AGVOLUTION/arduino_weatherstation/images/solar_6.JPEG

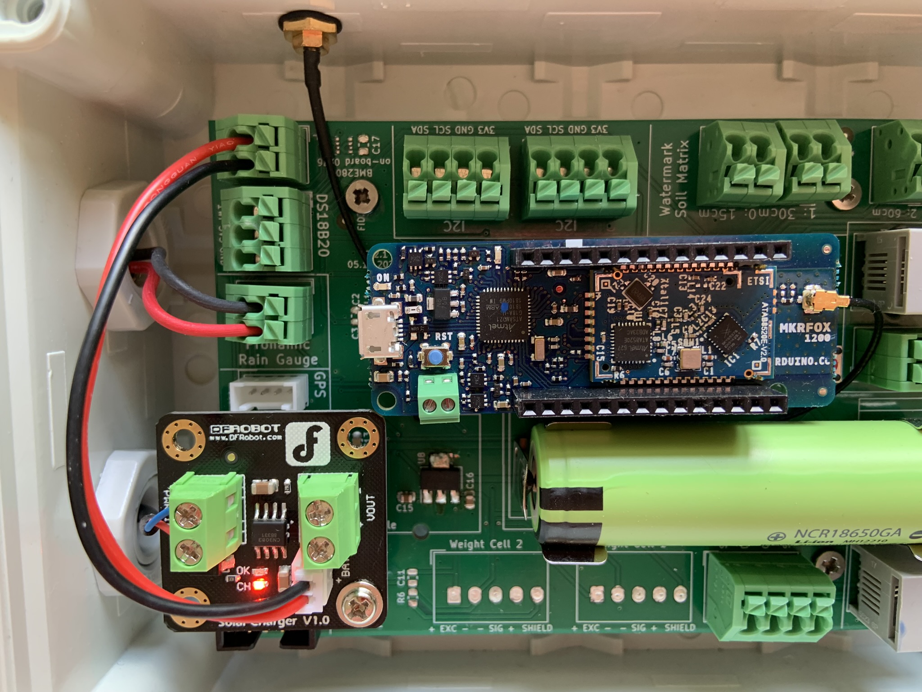
images/solar_6.JPEG
