AGVOLUTION/arduino_weatherstation/images/solar_3.JPEG

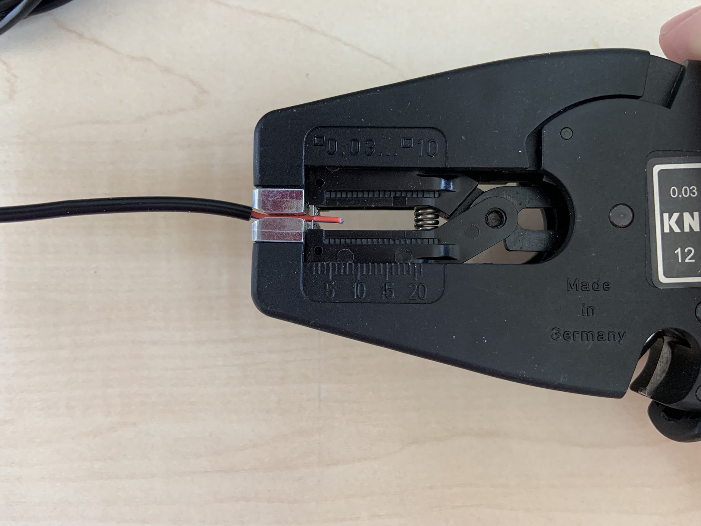
images/solar_3.JPEG
