AGVOLUTION/arduino_weatherstation/images/Farmalyzer_app_quer.png

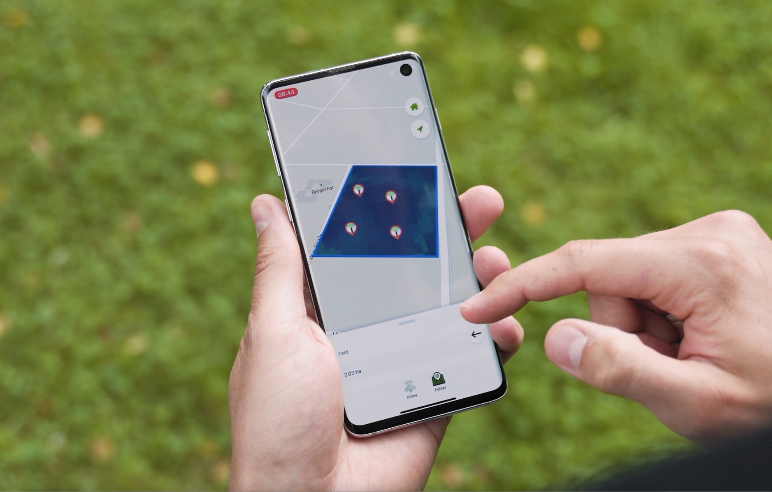
images/Farmalyzer_app_quer.png
