AGVOLUTION/arduino_weatherstation/images/sigfox_prototyp1.jpg

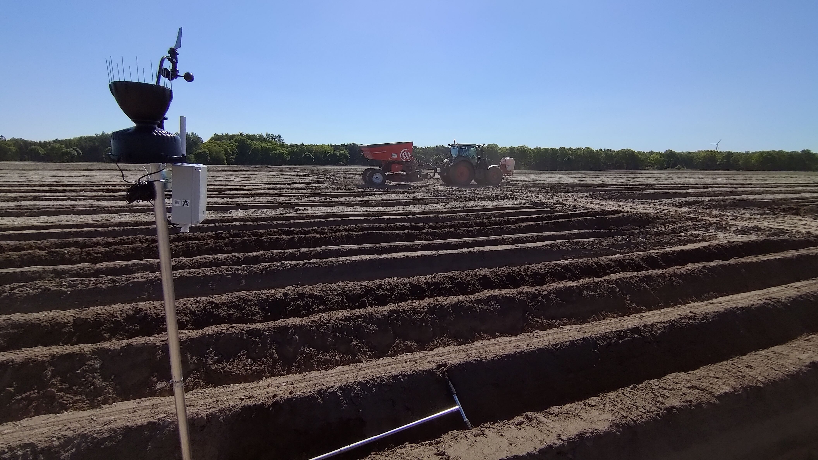
images/sigfox_prototyp1.jpg
