AGVOLUTION/arduino_weatherstation/images/sigfox_prototyp2.jpg

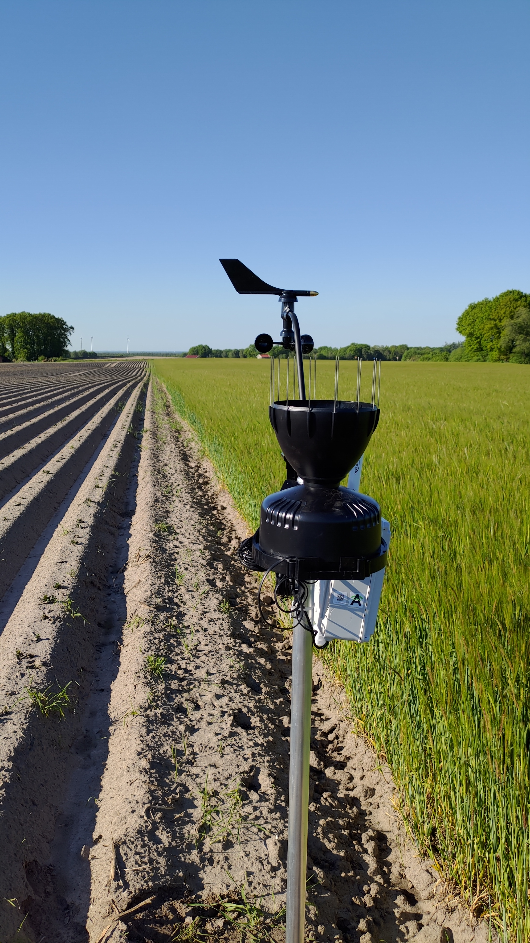
images/sigfox_prototyp2.jpg
