AGVOLUTION/arduino_weatherstation/images/solar_1.JPEG

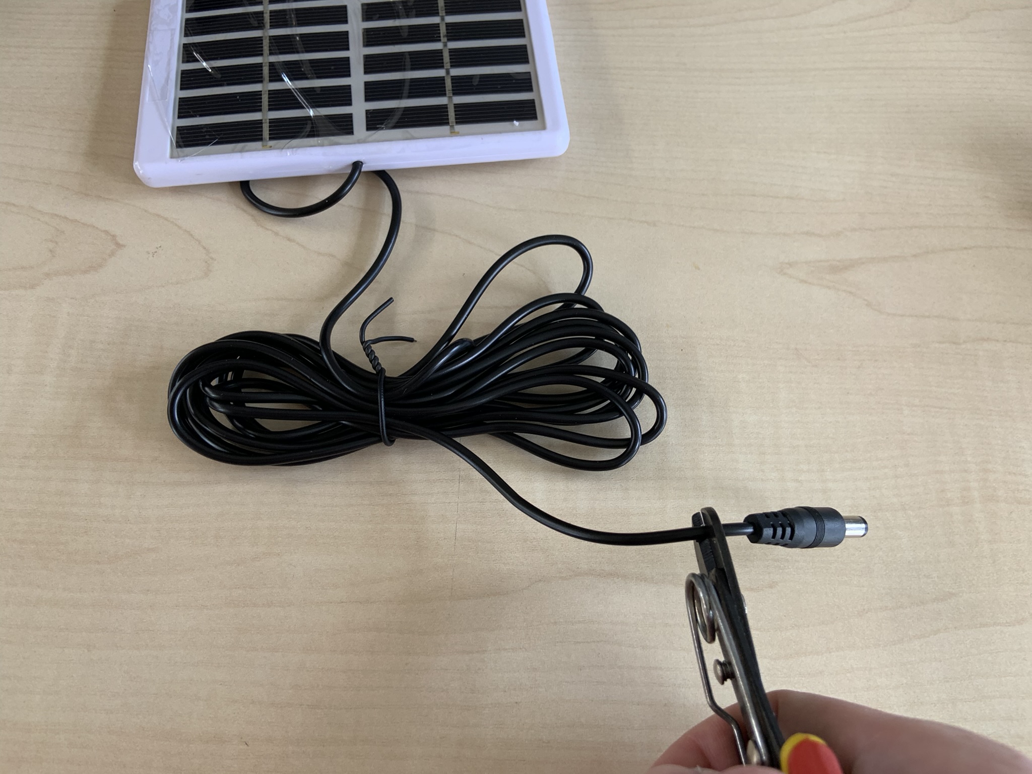
images/solar_1.JPEG
