AGVOLUTION/arduino_weatherstation/images/solar_2.JPEG

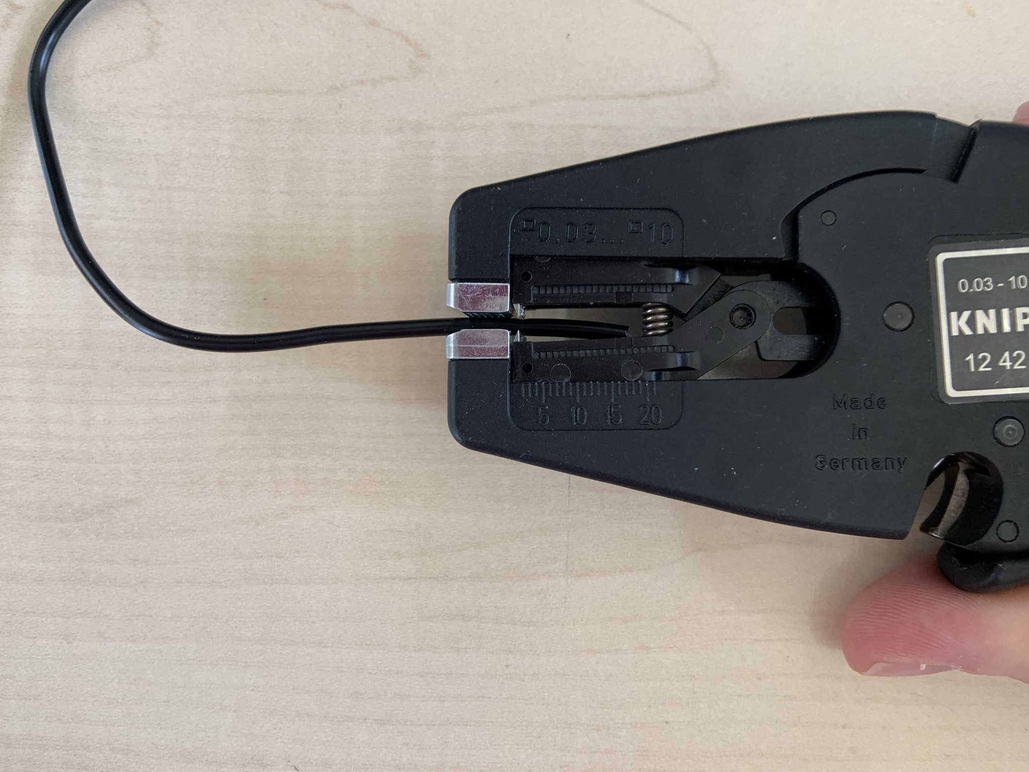
images/solar_2.JPEG
