AGVOLUTION/arduino_weatherstation/images/solar_4.JPEG

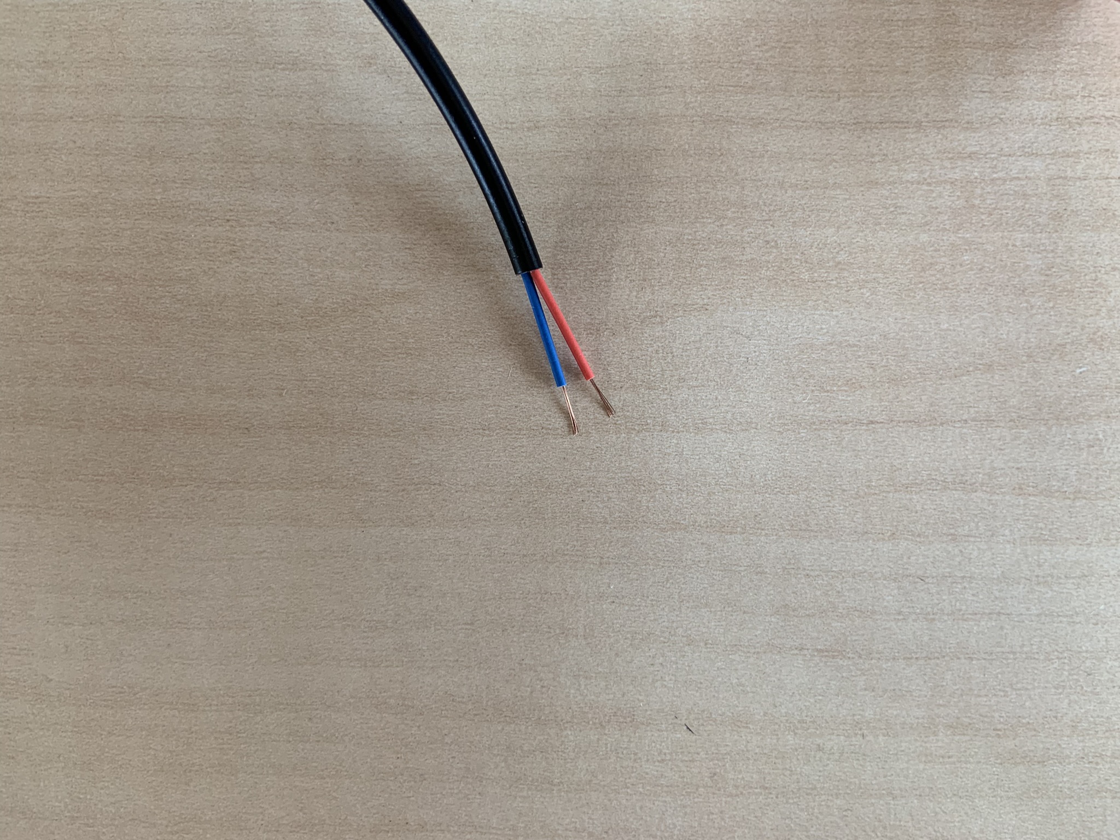
images/solar_4.JPEG
