AGVOLUTION/arduino_weatherstation/images/solar_5.JPEG

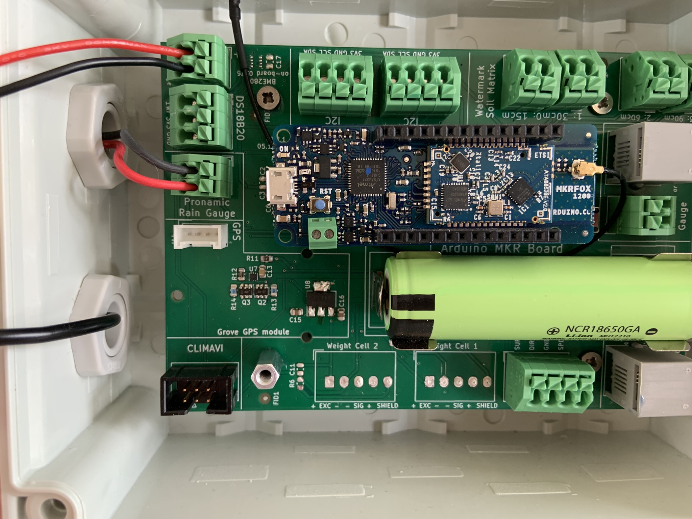
images/solar_5.JPEG
