AGVOLUTION/arduino_weatherstation/images/wind_1.JPEG

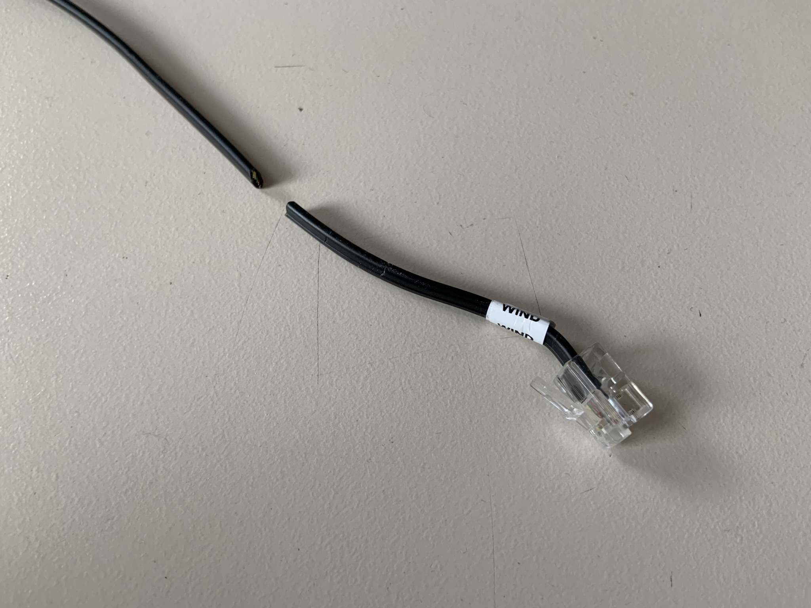
images/wind_1.JPEG
