AGVOLUTION/arduino_weatherstation/images/wind_2.JPEG

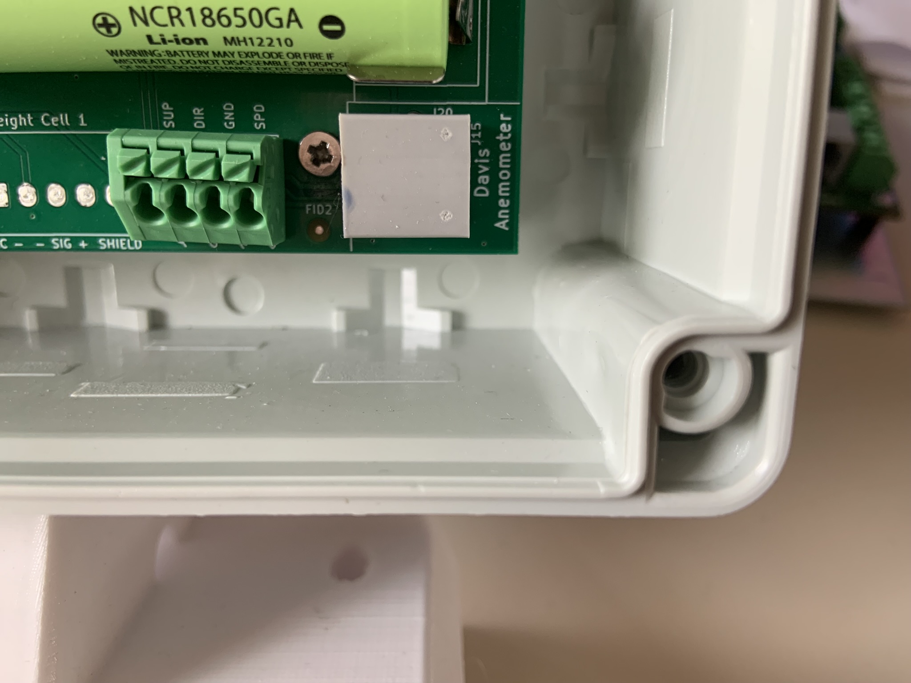
images/wind_2.JPEG
