AGVOLUTION/arduino_weatherstation/images/wind_3.JPEG

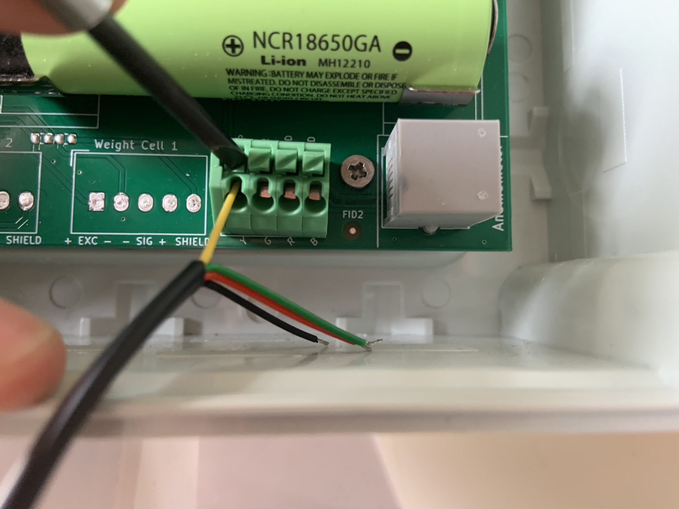
images/wind_3.JPEG
