AGVOLUTION/arduino_weatherstation/images/wind_4.JPEG

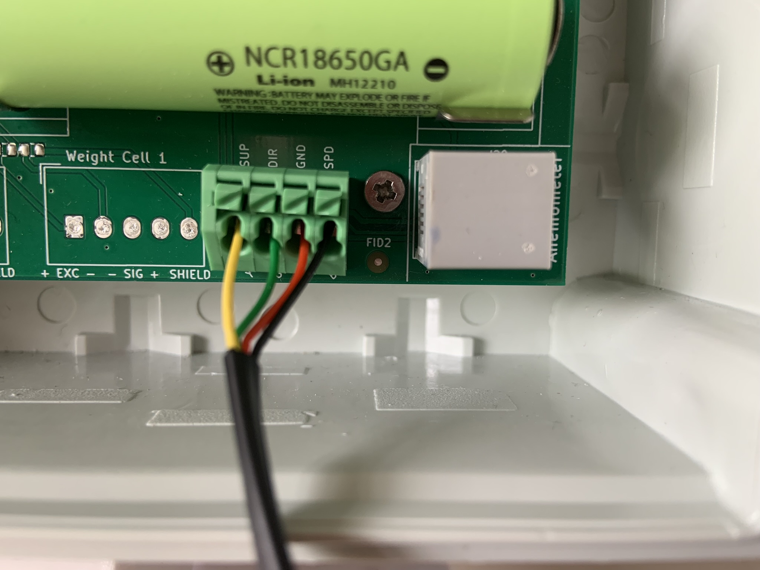
images/wind_4.JPEG
