AGVOLUTION/arduino_weatherstation/hardware/V2.2.1/BOM Wetterstation_25_10_21.ods

 | BOM Wetterstation V2_2_1
 | 25/10/2021
Qty | Value | Package | Part | Description | Voltage | Current | Tolerance | Manufacturer | Manuf. Part No. | Distributor | Distr. Part No. | Anmerkung
3 | 100nF | C_0805_2012Metric | C1, C13, C14 | Unpolarized capacitor | 5V
0 | 100nF | C_0805_2012Metric | C2, C3, C4, C5, C6, C7, C8, C9, C10, C11, C12, C17 | Unpolarized capacitor |  |  |  |  |  |  |  | Nicht bestückt.
2 | 4.7 uF | C_0805_2012Metric | C15, C16 | Unpolarized capacitor | 3,3V
7 | Conn_01x02_Male | 1x02_P3.50mm_Vertical | J1, J5, J6, J8, J9, J10, J21 | Generic connector, single row, 01x02 | X | X | X | Phoenix Contact | 1984963 | Digikey | 277-6354-ND | https://de.farnell.com/wago/250-102/tb-wire-to-brd-2pos-16awg/dp/3276925?st=250-102
1 | Conn_01x03_Male | 1x03_P3.50mm_Vertical | J11 | Generic connector, single row, 01x03 | X | X | X | Phoenix Contact | 1984976 | Digikey | 277-6355-ND
3 | Conn_01x04_Male | 1x04_P3.50mm_Vertical | J4, J12, J13 | Generic connector, single row, 01x04 | X | X | X | Phoenix Contact | 1984989 | Digikey | 277-6404-ND
0 | Conn_01x05_Female | 1x05_P3.50mm_Vertical | J17, J18 | Generic connector, single row, 01x05 | X | X | X | Phoenix Contact | 1861962 | Digikey | 277-12127-ND | Nicht bestückt.
1 | Conn_01x04_Male | 1x04_P2.00mm_Vertical | J14 | GROVE 2MM 4PIN VERT CONN | X | X | X | Seeed Technology Co., Ltd. | 110990030 | Digikey | 1597-1082-ND
2 | Conn_01x14_Female | 1x14_P2.54mm_Vertical | J2, J3 | Conn header vert 14pos 2.54mm | X | X | X | Sullins Connector Solutions | PPPC141LFBN-RC | Digikey | S7047-ND
1 | Conn_02x03_Odd_Even | IDC-Header_2x03_P2.54mm_Vertical | J7 | IDC Connector 6pos | X | X | X | 3M | 30306-6002HB | Digikey | 3M15451-ND | Vergoldete Kontakte wichtig!
0 | RJ14 | RJ14_Connfly_DS1133-S4_Horizontal | J15, J16 | RJ connector, 6P4C (6 positions 4 connected) | X | X | X | Würth | 615004138421 | Würth |  | Nicht bestückt.
2 | Conn_01x01_Female | BatteryHolder_Keystone_Clip_54 | J19, J20 | Generic connector, single row, 01x01 | X | X | X | Keystone Electronics | 54 | Digikey | 36-54-ND
0 | 4.7uH | L_0805_2012Metric | L1 | Inductor | X | 600 mA | 20,00% | TDK Corporation | MLZ2012N4R7LT000 | Digikey | 445-6760-1-ND | Nicht bestückt.
1 | DMN65D8LDW | SOT-363, SC-70-6 | Q1 | MOSFET 2N-CH 60V 180MA SOT363 | 60 V | 200 mA | X | Diodes Incorporated | DMN65D8LDWQ-7 | Mouser | 621-DMN65D8LDWQ-7
2 | DMN3115UDM | SOT-23-6 | Q2, Q3 | 6.9A Id, 30V Vds, N-Channel MOSFET, SOT-23-6 | 30 V | 3.2 A | X | Diodes Incorporated | DMN3115UDM-7 | Digikey | DMN3115UDMDICT-ND
1 | 7.87k | R_0805_2012Metric | R3 | Resistor | X | X | 0.5% | Susumu | RR1220P-7871-D-M | Digikey | RR12P7.87KDCT-ND
1 | 10k | R_0805_2012Metric | R4 | Resistor
0 | 0 | R_0805_2012Metric | R5, R6 | Resistor |  |  |  |  |  |  |  | Nicht bestückt.
0 | 150 | R_0805_2012Metric | R7, R8 | Resistor | X | X | 1,00% | YAGEO | RT0805FRE07150RL | Digikey | RT0805FRE07150RL | Nicht bestückt.
0 | 33k | R_0805_2012Metric | R9, R10 | Resistor |  |  |  |  |  |  |  | Nicht bestückt.
1 | 330 | R_0805_2012Metric | R11 | Resistor
1 | 2k2 | R_0805_2012Metric | R12 | Resistor
2 | 4.7M | R_0805_2012Metric | R13, R14 | Resistor
1 | SW_Push | SMD_SPST_PTS645 | SW1 | Push button switch, generic, two pins | X | X | X | C&K | PTS645SK50SMTR92 LFS | Digikey | CKN9087CT-ND
2 | CD4051BM96G3 | 16-SOIC | U1, U2 | Analog Multiplexer 8 to 1 lins | X | X | X | Texas Instruments | CD4051BM96G3 | Digikey | 296-31505-1-ND
0 | LTC1983-5 | TSOT-23-6 | U3 | IC REG CHARGE PUMP -5V TSOT23-6 | X | X | X | Analog Devices Inc. | LTC1983ES6-5#TRPBF | Digikey | LTC1983ES6-5#TRPBFCT-ND | Nicht bestückt.
0 | MCP1642B | SOT223 | U4 | IC REG LINEAR 3.3V 1A | X | X | X | Microchip Technology | MCP1642B-50I/MS | Digikey | MCP1642B-50I/MS-ND | Nicht bestückt.
0 | INA126 | MSOP-8-1EP | U5, U6 | IC INST AMP 1 CIRCUIT 8VSSOP | X | X | X | Texas Instruments | INA126EA/2K5 | Digikey | 296-41257-1-ND | Nicht bestückt.
1 | BQ297xy | WSON-6 | U7 | Voltage and Current Protection for Single-Cell Batteries | X | X | X | Texas Instruments | BQ29732DSER | TI Store | BQ29732DSER | https://www.ti.com/store/ti/en/p/product/?p=BQ29732DSER
1 | ZLDO1117G33TA | SOT-223-3 | U8 | 1A LDO regulator, positive, 3.3V fixed output, SOT-223 | 3.3 V | 1 A | X | Diodes Incorporated | ZLDO1117G33TA | Digikey | ZLDO1117G33DICT-ND
0 | BME280 | LGA-8 | U9 | 3-in-1 sensor, humidity, pressure, temperature, I2C | X | X | X | Bosch Sensortec |  |  |  | Nicht bestückt.
 | Falls nicht anders angegeben alle Widerstände 1%
 | Falls nicht anders angegeben alle Kerkos 10% Dielektrikum X7R, außer aufgrund der Bauform nur X5R oder 20% verfügbar.
