AGVOLUTION/arduino_weatherstation/energy-benchmark/energy-benchmark_hw_v2.2.1.xlsx

 |  | DEBUG_SERIAL = 1 |  |  |  |  | DEBUG_SERIAL = 0 |  |  |  |  | DEBUG_SERIAL = 1 |  |  | DEBUG_SERIAL = 0 |  |  | DEBUG_SERIAL = 1
 |  | Sleep Current (before LDO) | Sleep Current (after LDO) | Sensor reading |  |  | Sleep Current (before LDO) | Sleep Current (after LDO) | Sensor reading |  |  | per Rain Event or Wind Sample |  |  | per Rain Event or Wind Sample |  |  | Payloads
Setup / Sensor equipment | No. | Iavg (uA) | Iavg (uA) | t (s) | Iavg (uA) | Energy (uJ) | Iavg (uA) | Iavg (uA) | t (s) | Iavg (uA) | Energy (uJ) | t (s) | Iavg (uA) | Energy (uJ) | t (s) | Iavg (uA) | Energy (uJ) | t (s) | Iavg (uA) | Energy (uJ)
Without peripheral sensors | 1_2 | 199 | 199 | 0.692 | 11982 | 27678 | 167 | 167 | 0.576 | 12284 | 23106
Watermarks (4x) | 2 | 276 | 166 | 1.057 | 12174 | 42182 | 251 | 134 | 0.742 | 12633 | 31268
DS18B20 (1x) | 3 | 280 | 170 | 1.725 | 12029 | 68671 | 251 | 134 | 1.38 | 12866 | 58593
Rain Event (Pronamic or Davis) | 4 |  |  |  |  |  |  |  |  |  |  | 0.25 | 9449 | 7796 | 0.16 | 9835 | 5193
SHT (1x) | 5 | 278 | 168 | 1.070 | 12026 | 42462
BME 0x76 (1x) | 6 | 285 | 175 | 1.253 | 11993 | 48874 | 263 | 146 | 0.724 | 12760 | 30739
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
