AGVOLUTION/arduino_weatherstation/hardware/V2.2.1/mkrfox1200.kicad_pcb

## KiCad design hardware/V2.2.1/mkrfox1200.kicad_pcb (2022-05-15)

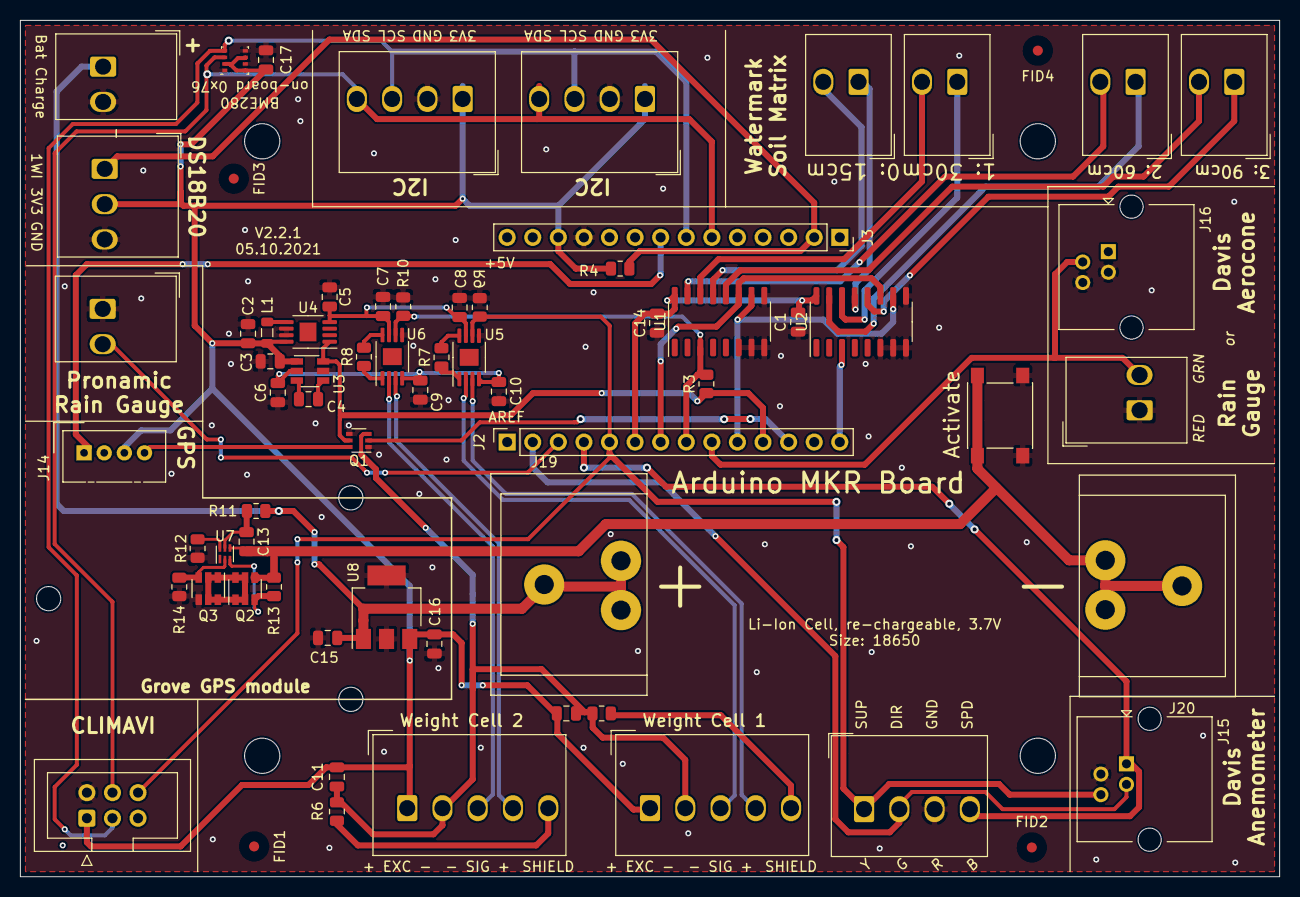
[picture p14: board mkrfox1200.kicad_pcb from above]

Board: 2 copper layers, 125.0 x 85.0 mm, 69 parts (1 on the bottom side), 50 nets.

Parts:
C1, C2, C3, C4, C5, C6, C7, C8, C9, C10, C11, C12, C13, C14, C17: 100nF; C_0805_2012Metric
C15, C16: 4.7uF; C_0805_2012Metric
FID1, FID2, FID3, FID4: Fiducial; Fiducial_1mm_Mask3mm
J1, J5, J6, J8, J9, J10: Conn_01x02_Male; Phoenix_19_84_96_3_1x02_P3.50mm_Vertical
J2, J3: Conn_01x14_Female; PinSocket_1x14_P2.54mm_Vertical
J4, J12, J13: Conn_01x04_Male; Phoenix_19_84_98_9_1x04_P3.50mm_Vertical
J7: Conn_02x03_Odd_Even; IDC-Header_2x03_P2.54mm_Vertical
J11: Conn_01x03_Male; Phoenix_19_84_97_6_1x03_P3.50mm_Vertical
J14: Conn_01x04_Male; NS-Tech_Grove_1x04_P2mm_Vertical
J15, J16: RJ14; RJ14_Wuerth_615004138421_Horizontal
J17, J18: Conn_01x05_Female; Phoenix_19_84_99_2_1x05_P3.50mm_Vertical
J19, J20: Conn_01x01_Female; BatteryClip_Keystone_54
J21: Conn_01x02; Phoenix_19_84_96_3_1x02_P3.50mm_Vertical
L1: 4.7uH; L_0805_2012Metric
Q1: DMN65D8LDW; SOT-363_SC-70-6
Q2, Q3: DMN3115UDM; SOT-23-6
QR*****: QR_Code_agvolution.com
R3: 7.87k; R_0805_2012Metric
R4: 10k; R_0805_2012Metric
R5, R6: 0; R_0805_2012Metric
R7, R8: 150; R_0805_2012Metric
R9, R10: 33k; R_0805_2012Metric
R11: 330; R_0805_2012Metric
R12: 2k2; R_0805_2012Metric
R13, R14: 4.7M; R_0805_2012Metric
SW1: SW_Push; SW_SPST_PTS645
U1, U2: 4051; SO-16_3.9x9.9mm_P1.27mm
U3: LTC1983-5; TSOT-23-6
U4: MCP1642B-50; MSOP-8-1EP_3x3mm_P0.65mm_EP1.68x1.88mm
U5, U6: INA126; MSOP-8-1EP_3x3mm_P0.65mm_EP1.68x1.88mm
U7: BQ297xy; WSON-6_1.5x1.5mm_P0.5mm
U8: ZLDO1117G33TA; SOT-223-3_TabPin2
U9: BME280; Bosch_LGA-8_2.5x2.5mm_P0.65mm_ClockwisePinNumbering

Connections:
+3V3: C2.2, C3.2, C11.1, C12.1, C16.2, C17.1, J3.12, J7.1, J11.2, J12.1, J13.1, J14.3, J17.1, J18.1, L1.1, R4.2, U3.1, U4.8, U8.3, U9.2, U9.6, U9.8
+5V: C5.1, C7.1, C8.1, U4.4, U5.7, U6.7
-5V: C6.1, C9.1, C10.1, U3.2, U5.4, U6.4
AGV_MOISTURE_EN: J2.5, J4.1, J7.6, J15.4, R9.1, U5.6
DAVIS_RAIN: J2.9, J5.2, J16.2
DAVIS_WIND_DIR: J2.2, J4.2, J15.3
DAVIS_WIND_SPD: J2.4, J4.4, J15.1
DS18B20_1W: J3.2, J11.1, R4.1
EXC-_1: C11.2, C12.2, J17.2, J18.2, Q1.3, R5.1, R6.1
GND: C1.2, C2.1, C3.1, C5.2, C6.2, C7.2, C8.2, C9.2, C10.2, C14.2, C15.1, C16.1, C17.2, J1.1, J3.11, J4.3, J5.1, J7.2, J11.3, J12.2, J13.2, J15.2, J16.3, J16.4, J21.2, Q1.1, Q1.4, Q3.4, R9.2, R10.2, R12.1, R14.1, SW1.1, U1.6, U1.7, U1.8, U1.9, U2.6, U2.7, U2.8, U2.9, U3.5, U4.6, U4.7, U5.5, U6.5, U8.2, U9.1, U9.5, U9.7
GPS_SUP: J2.12, Q1.2
GPS_TX: J3.8, J14.1
unnamed: C4.1, U3.4
unnamed: C4.2, U3.3
unnamed: C13.1, R11.2, U7.5
unnamed: C13.2, J20.1, Q2.4, R13.1, SW1.2, U7.4
unnamed: J6.1, U2.13
unnamed: J6.2, U1.13
unnamed: J8.1, U2.14
unnamed: J8.2, U1.14
unnamed: J9.1, U2.15
unnamed: J9.2, U1.15
unnamed: J10.1, U2.12
unnamed: J10.2, U1.12
unnamed: J14.4, Q1.6
unnamed: L1.2, U4.5
unnamed: Q2.1, Q2.2, Q2.5, Q2.6, Q3.1, Q3.2, Q3.5, Q3.6
unnamed: Q2.3, R13.2, U7.3
unnamed: Q3.3, R14.2, U7.2
unnamed: R7.1, U5.1
unnamed: R7.2, U5.8
unnamed: R8.1, U6.1
unnamed: R8.2, U6.8
unnamed: R12.2, U7.6
PRONAMIC_RAIN: J1.2, J2.3
SCL: J3.7, J7.3, J12.3, J13.3, U9.4
SDA: J3.6, J7.4, J12.4, J13.4, U9.3
SHLD1: J17.5, R5.2
SHLD2: J18.5, R6.2
SIG+_1: J17.3, U5.2
SIG+_2: J18.3, U6.2
SIG-_1: J17.4, U5.3
SIG-_2: J18.4, U6.3
VBAT+: C15.2, J19.1, J21.1, R11.1, U8.1
WEIGHT_2: J2.8, R3.1, R10.1, U1.3, U6.6
WEIGHT_EN: J2.11, Q1.5, R3.2, U3.6, U4.1
WM_A: J2.7, U1.11, U2.11
WM_B: J2.10, U1.10, U2.10
WM_EXC2: J2.14, U2.3
WM_SWITCH_SUP: C1.1, C14.1, J2.6, U1.16, U2.16
