AGVOLUTION/arduino_weatherstation/(commit log)

2021-05-20 Having the rain count timestamp reset after TX corrected.
    [commission.h, davisWind.h, hardware.h, rainCount.c, rainCount.h, sdlog.h]
2021-07-18 Read Watermark Soil Matrix Potential sensors.
2021-07-18 Generate a rectangular signal on a separate Arduino board in order to test the functionality of the tipping spoon interrupt.
2021-07-18 Major update of module libraries: 1. Reorganizing the BME280 interface, 2. Modernizing the wind and rain module 3. Adding a simple debug module 4. Adding a equipment list module 5. Adding a custom RT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
2021-07-18 Major software update: Coping with the new v2.0.0 pcb -> Able to read multiple external sensors: 2x BME280, Multiple DS18B20 (automatic address detection), 4x Watermark Soil Matrix Potential, Davis A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
    [hardware.h, sdlog.h]
2021-09-16 Bugfix: Rain counter (current) was not reset since method body was not implemented.
    [rain.cpp]
2021-09-16 Watermark: Preventing a leakage current through switch select pins A + B
    [watermark.cpp]
2021-09-16 Serial Debug Output. Modifications to GPS fixture times.
    [commission.h]
2021-10-20 Changing GPS packet frequency to every three days instead of every two days. UART debug frequency is 38400
2021-10-24 Bugfix: Names of Parameters and Attributes were identical. Led to wrong pin numbers in wind module.
    [wind.h]
2021-10-24 Using placeholder macro for debug serial device
2021-10-24 New payload format integration. Dual rain sensor. Dual SHT3x T/RH sensor.
2021-11-13 Adding Weatherstation Energy Benchmark files
    [Energieverbrauch_HW_2.2.2.xlsx]
2022-04-08 Removing device lists
2022-05-15 Adding hardware layout v2.2.1
    [BOM Wetterstation_25_10_21.ods, Battery.sch, DMSAmp.sch, mkrfox1200.kicad_pcb, mkrfox1200.sch]
2022-05-15 Moving Arduino Board schematics
2022-05-15 Updating energy-benchmark table -> Better overview, english
    [Energieverbrauch_HW_2.2.2.xlsx, energy-benchmark_hw_v2.2.1.xlsx]
2022-05-15 Correcting licensing and add build info segment
    [arduino_weatherstation.ino, bme280.cpp, bme280.h, buildInfo.h, debug.h, equipment.cpp, equipment.h, rain.cpp]
